NEOZEO64/hivecom/img/weight scale problem.jpeg

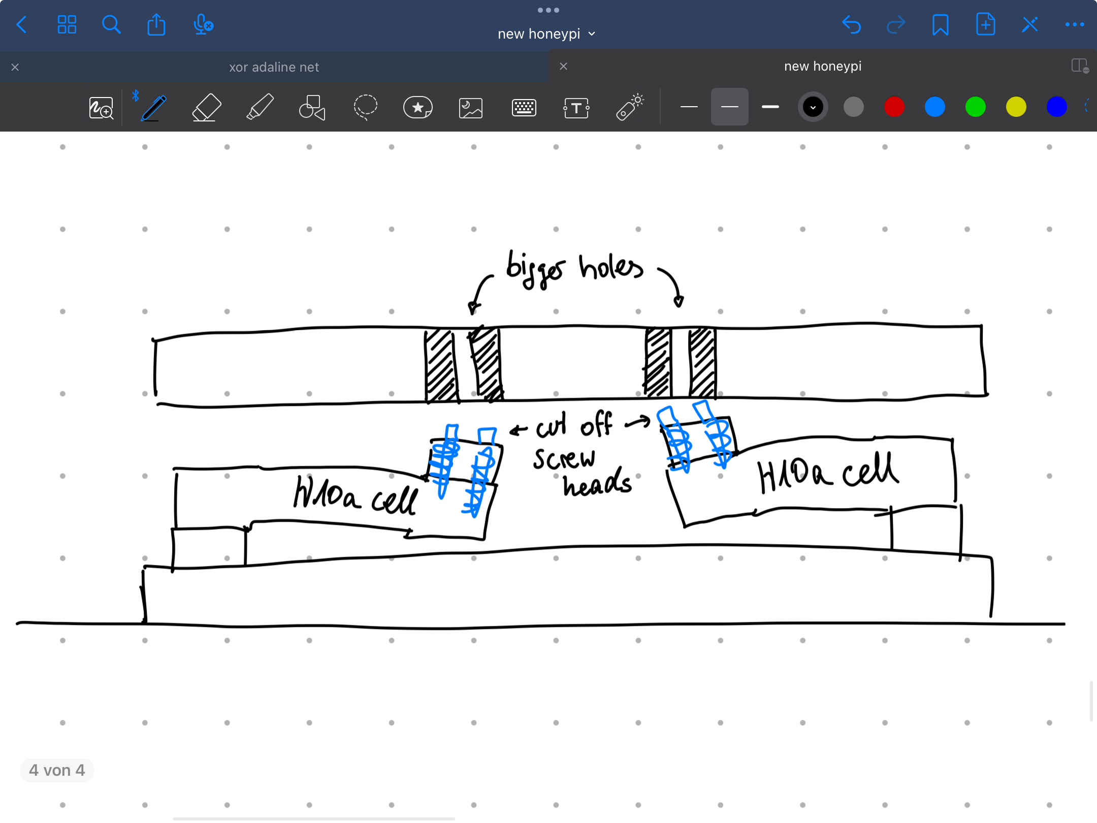
img/weight scale problem.jpeg
