NEOZEO64/hivecom/Hivecom Components.pdf

# Car

# hinn ↑

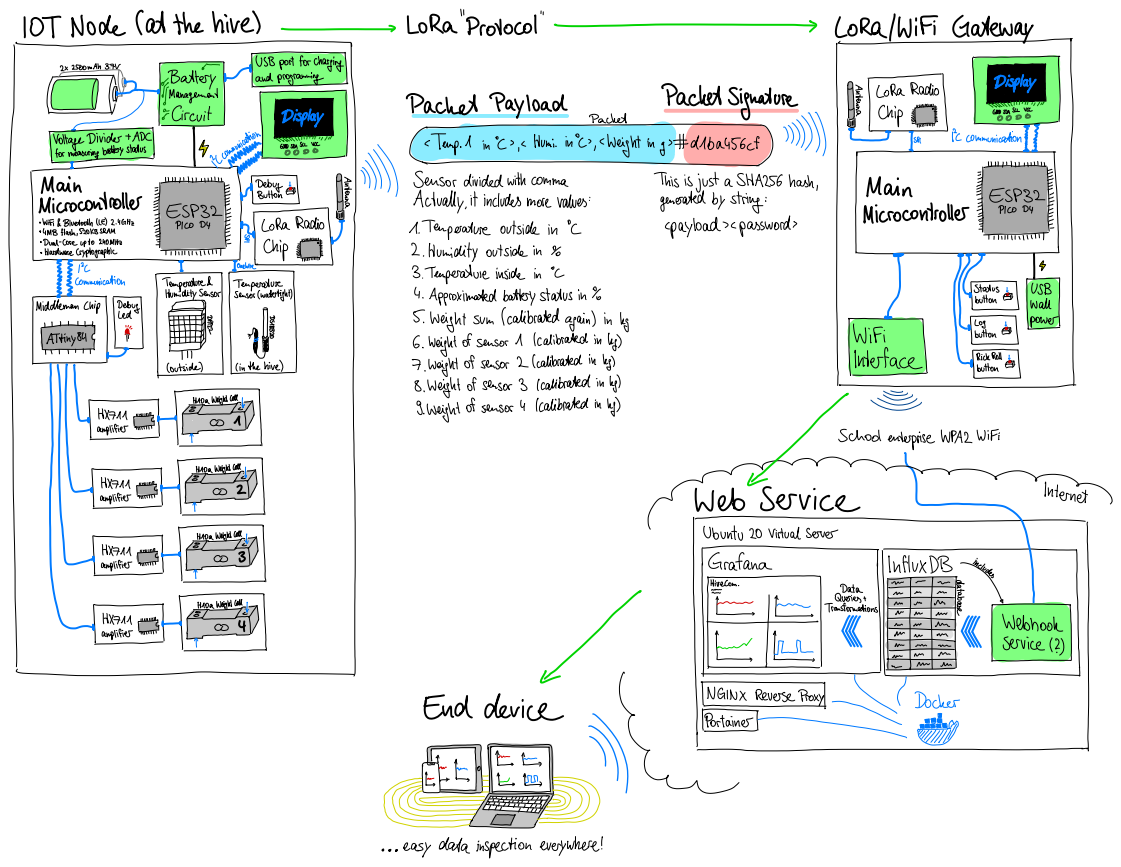
[picture p26: page 1]
2x2500mAh 37V; Batter/; Circuit; Packet Payload; Packet; Signature; Sensor divided with comma; This is just a SHA256 hash, Mou; Masin; Actually,it includes more values; generated by string:; Temperature outside in; 4 MB flash ,; 520B SRAM; payload passwords; Hardware Cryptographic; +ADC; Dual-Core up to 240MHz; 2.Humidity outside in %; Temperature inside in; Weight of sensor 1 (calibrated in hy); Weight of sensor 4 (calibrated in hy); End device; ↓que =; Portainer- I

WiFi & Bluetooth (LE) 2 .4 GHz

Approximated battery status in %
Weight sum (calibrated again) in by
Weight of sensor 2 (calibrated in hy)
Weight of sensor 3 (calibrated in hy)

/school enterprise WAL WiFi
