NEOZEO64/hivecom/IoT Node Schematic.pdf

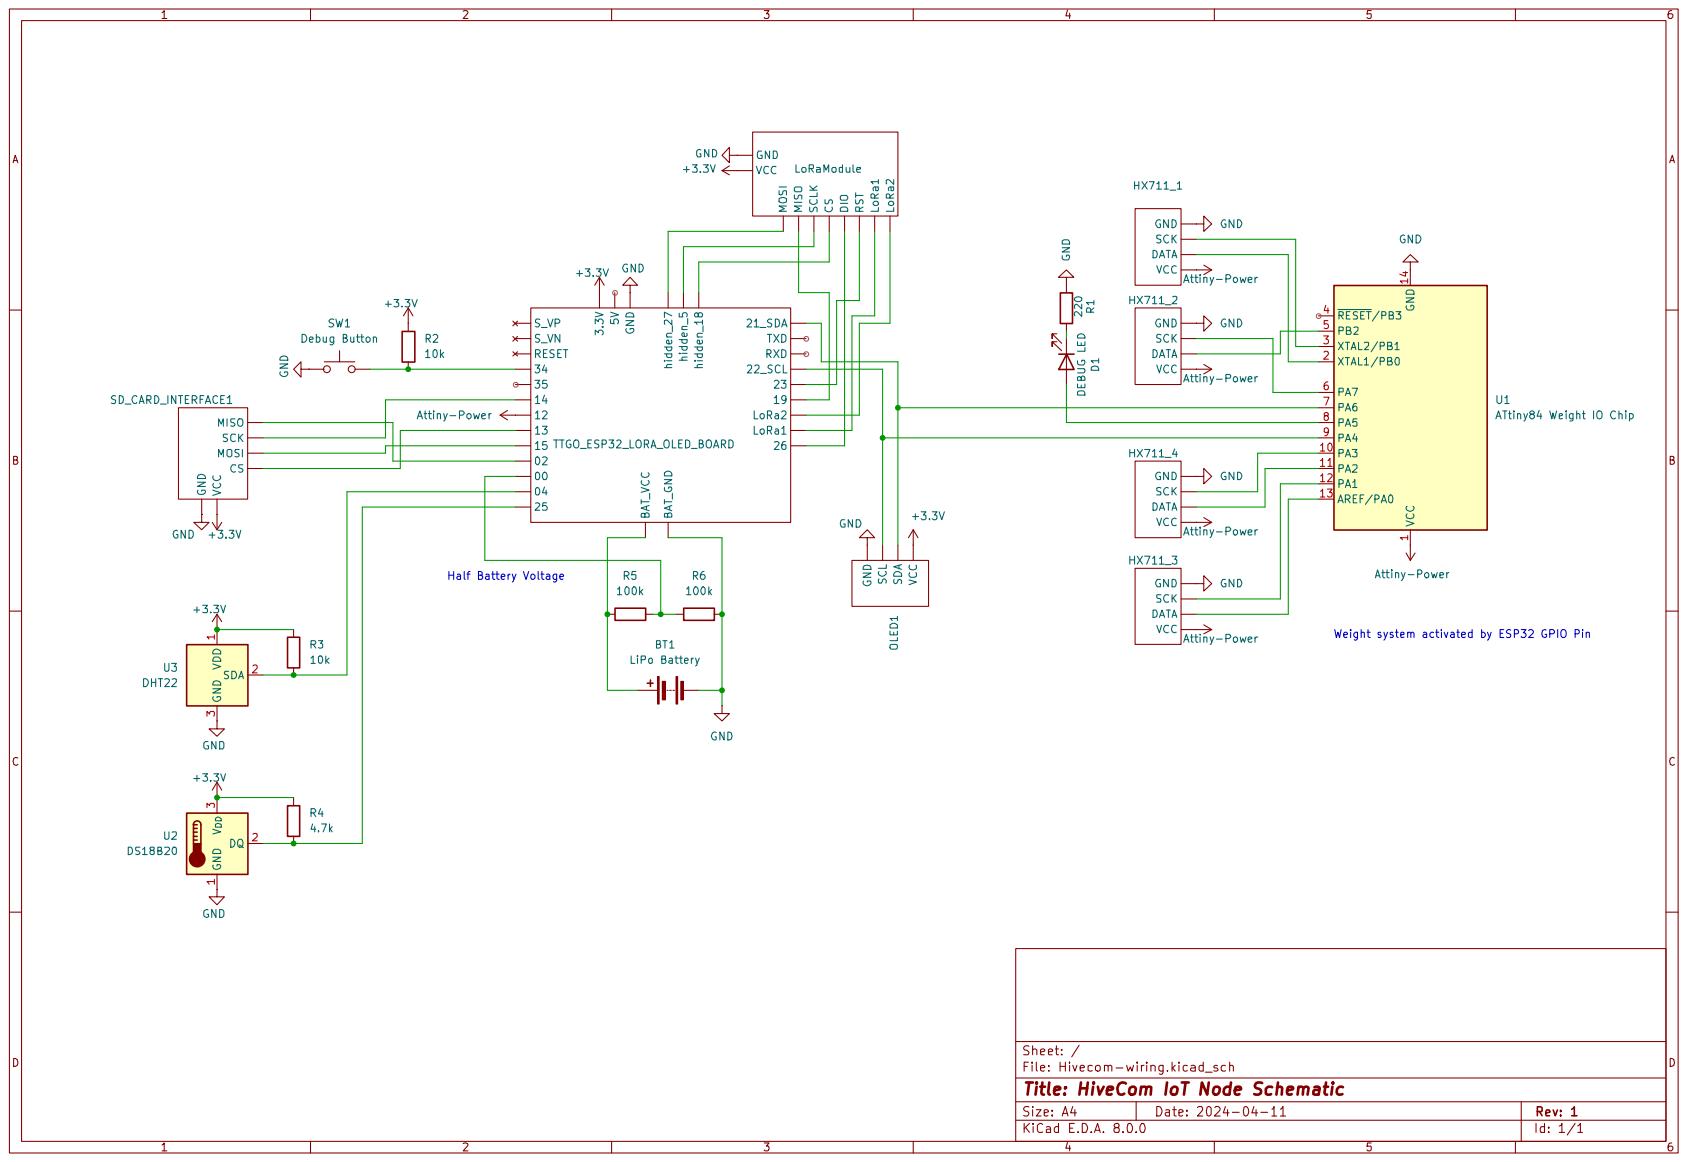
[picture p27: page 1]
